JopKoning-InsyteTechnology/EFRO_Breast_Cancer_Detection/impedance-match-USB.png

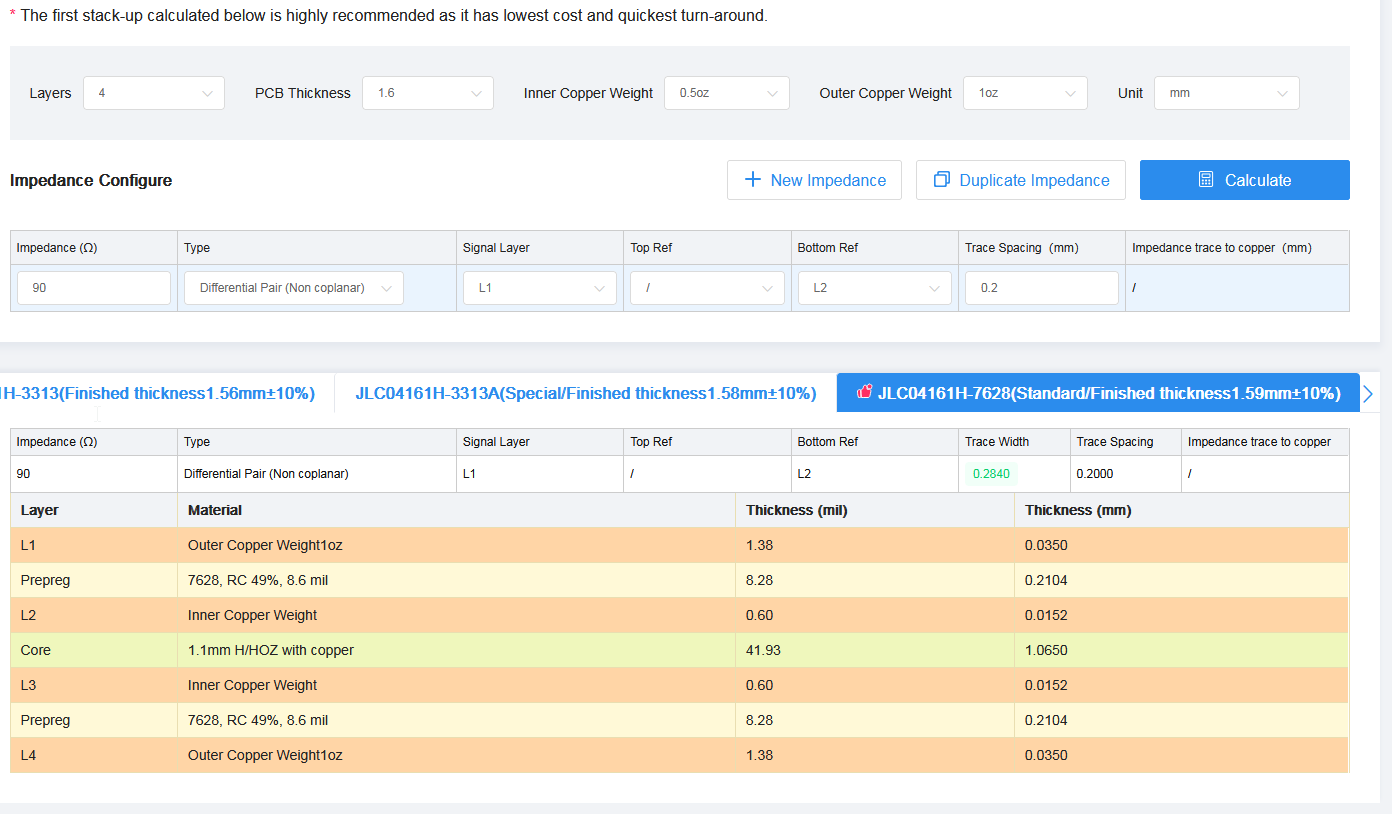
impedance-match-USB.png
