JopKoning-InsyteTechnology/EFRO_Breast_Cancer_Detection/Minimal_Prototype_Function_Generator_V0.1/Minimal_Prototype_Function_Generator_V0.1.kicad_pcb

## KiCad design Minimal_Prototype_Function_Generator_V0.1/Minimal_Prototype_Function_Generator_V0.1.kicad_pcb (2025-09-29)

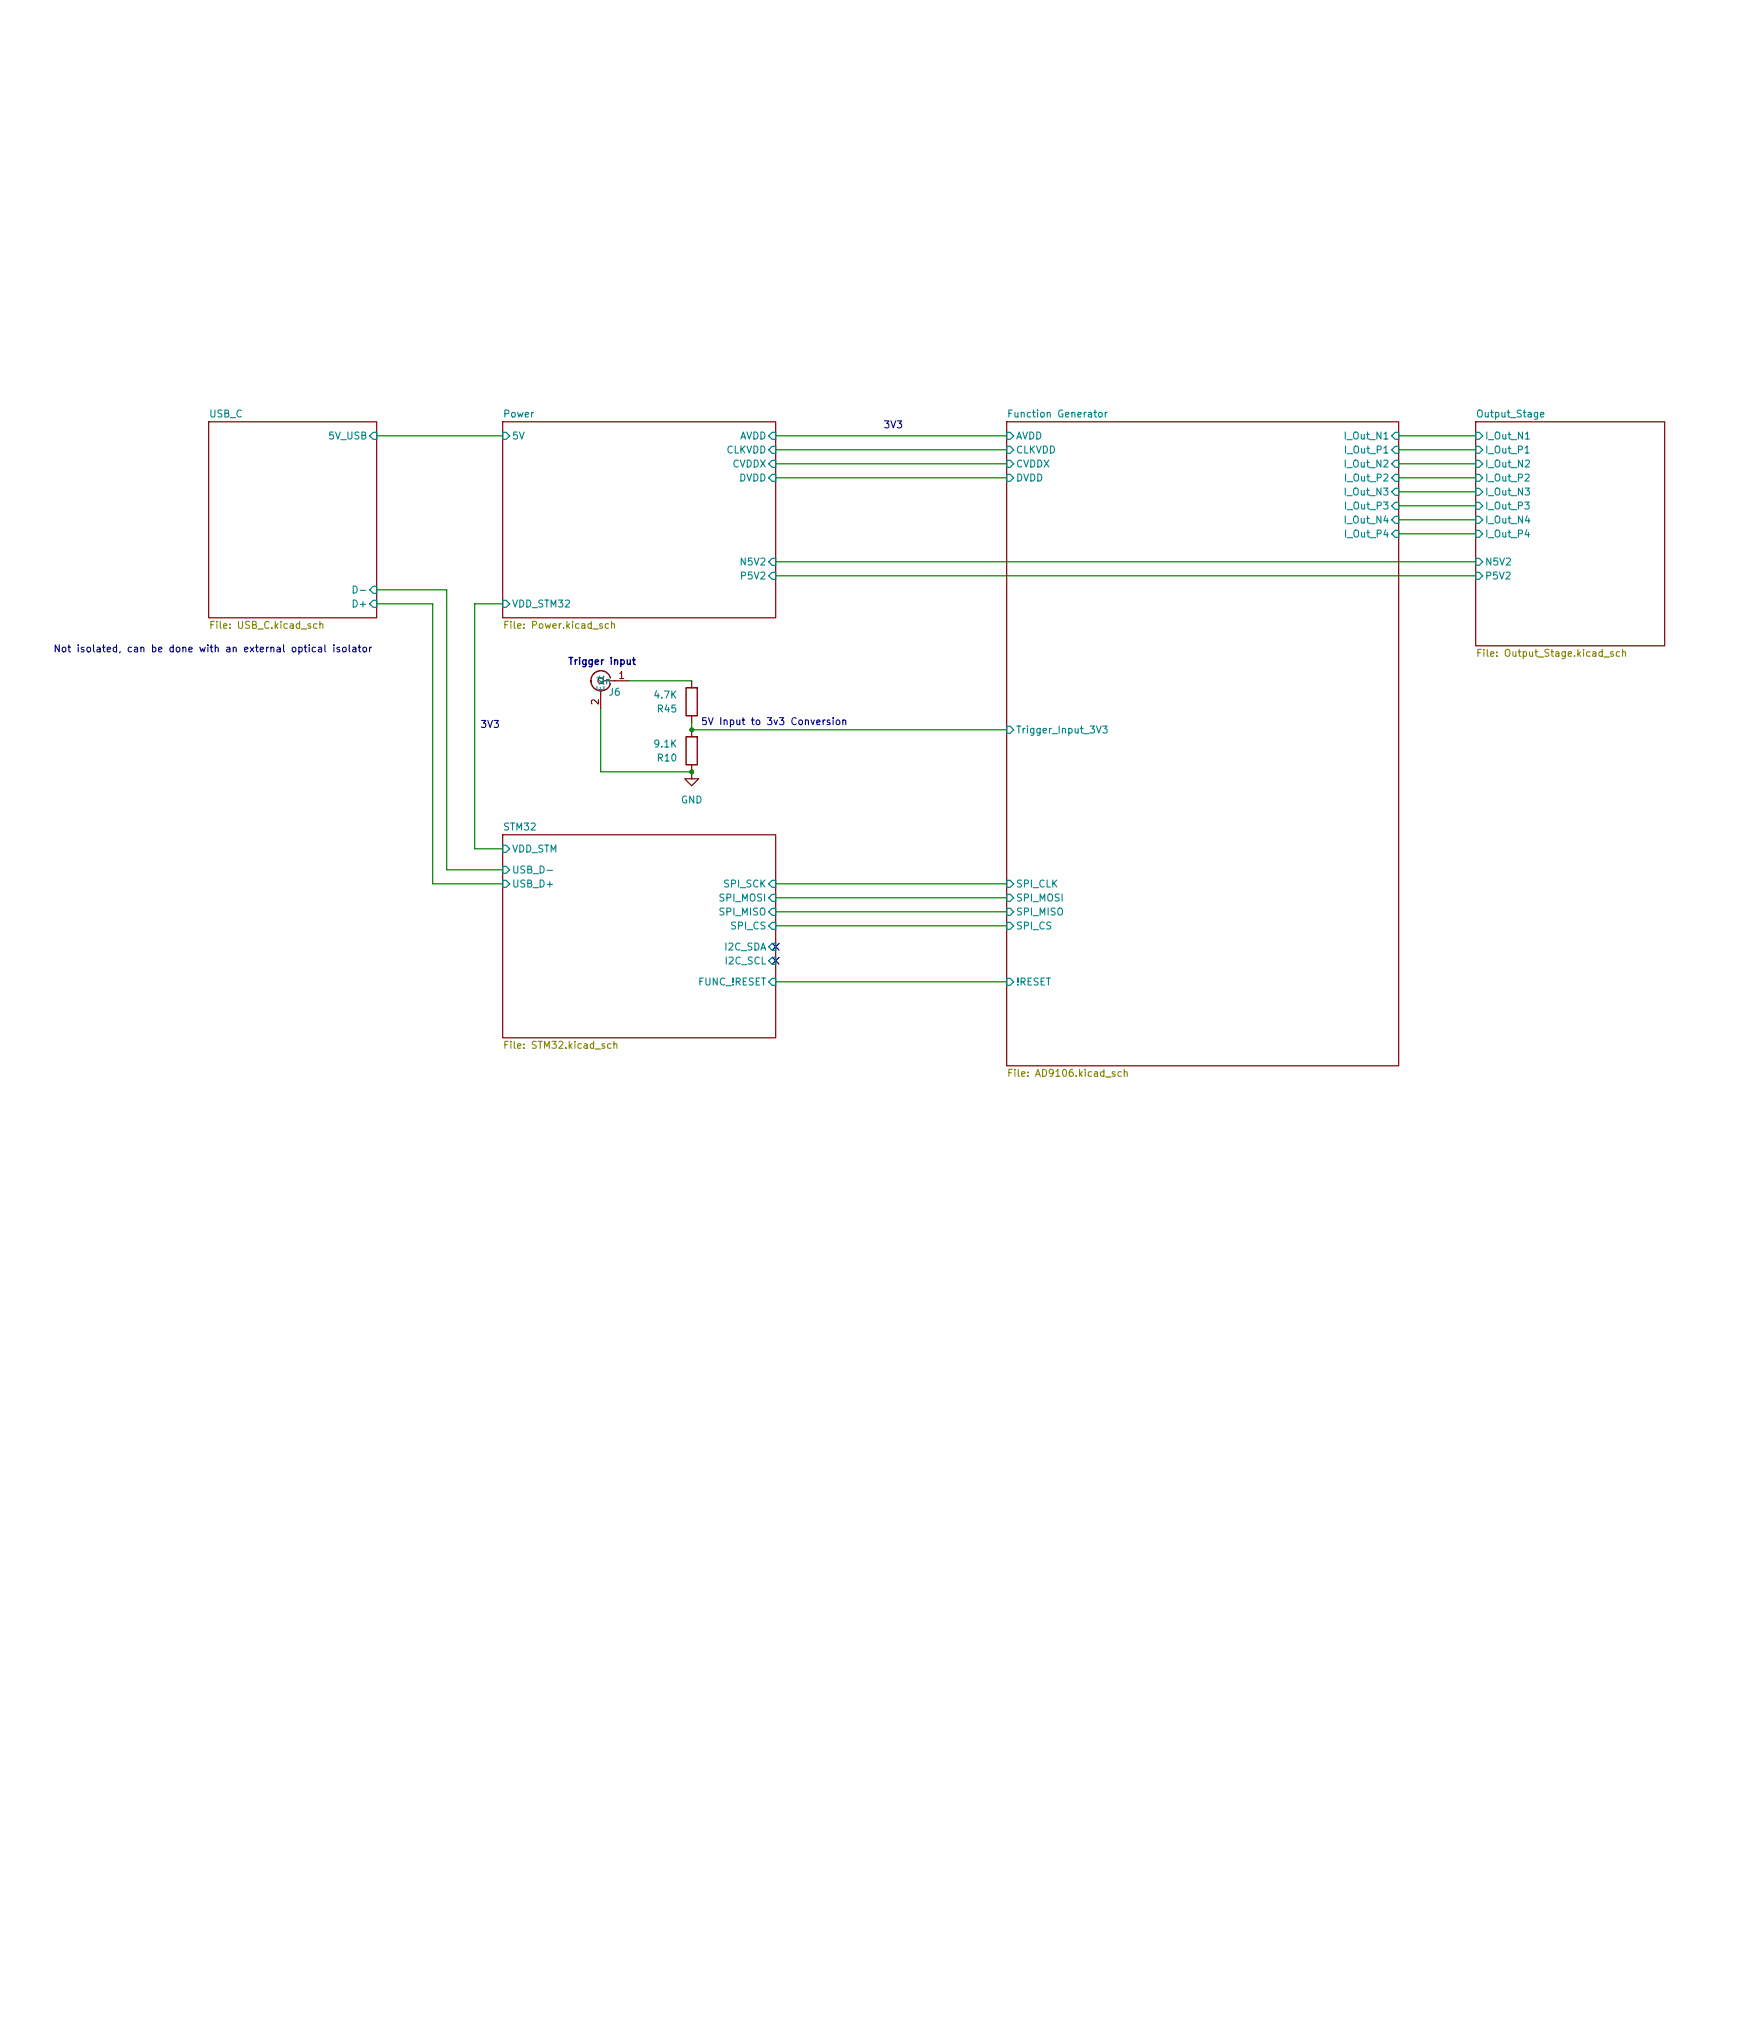
[picture p2: schematic Minimal_Prototype_Function_Generator_V0.1.kicad_sch, part in row 1, column 1]

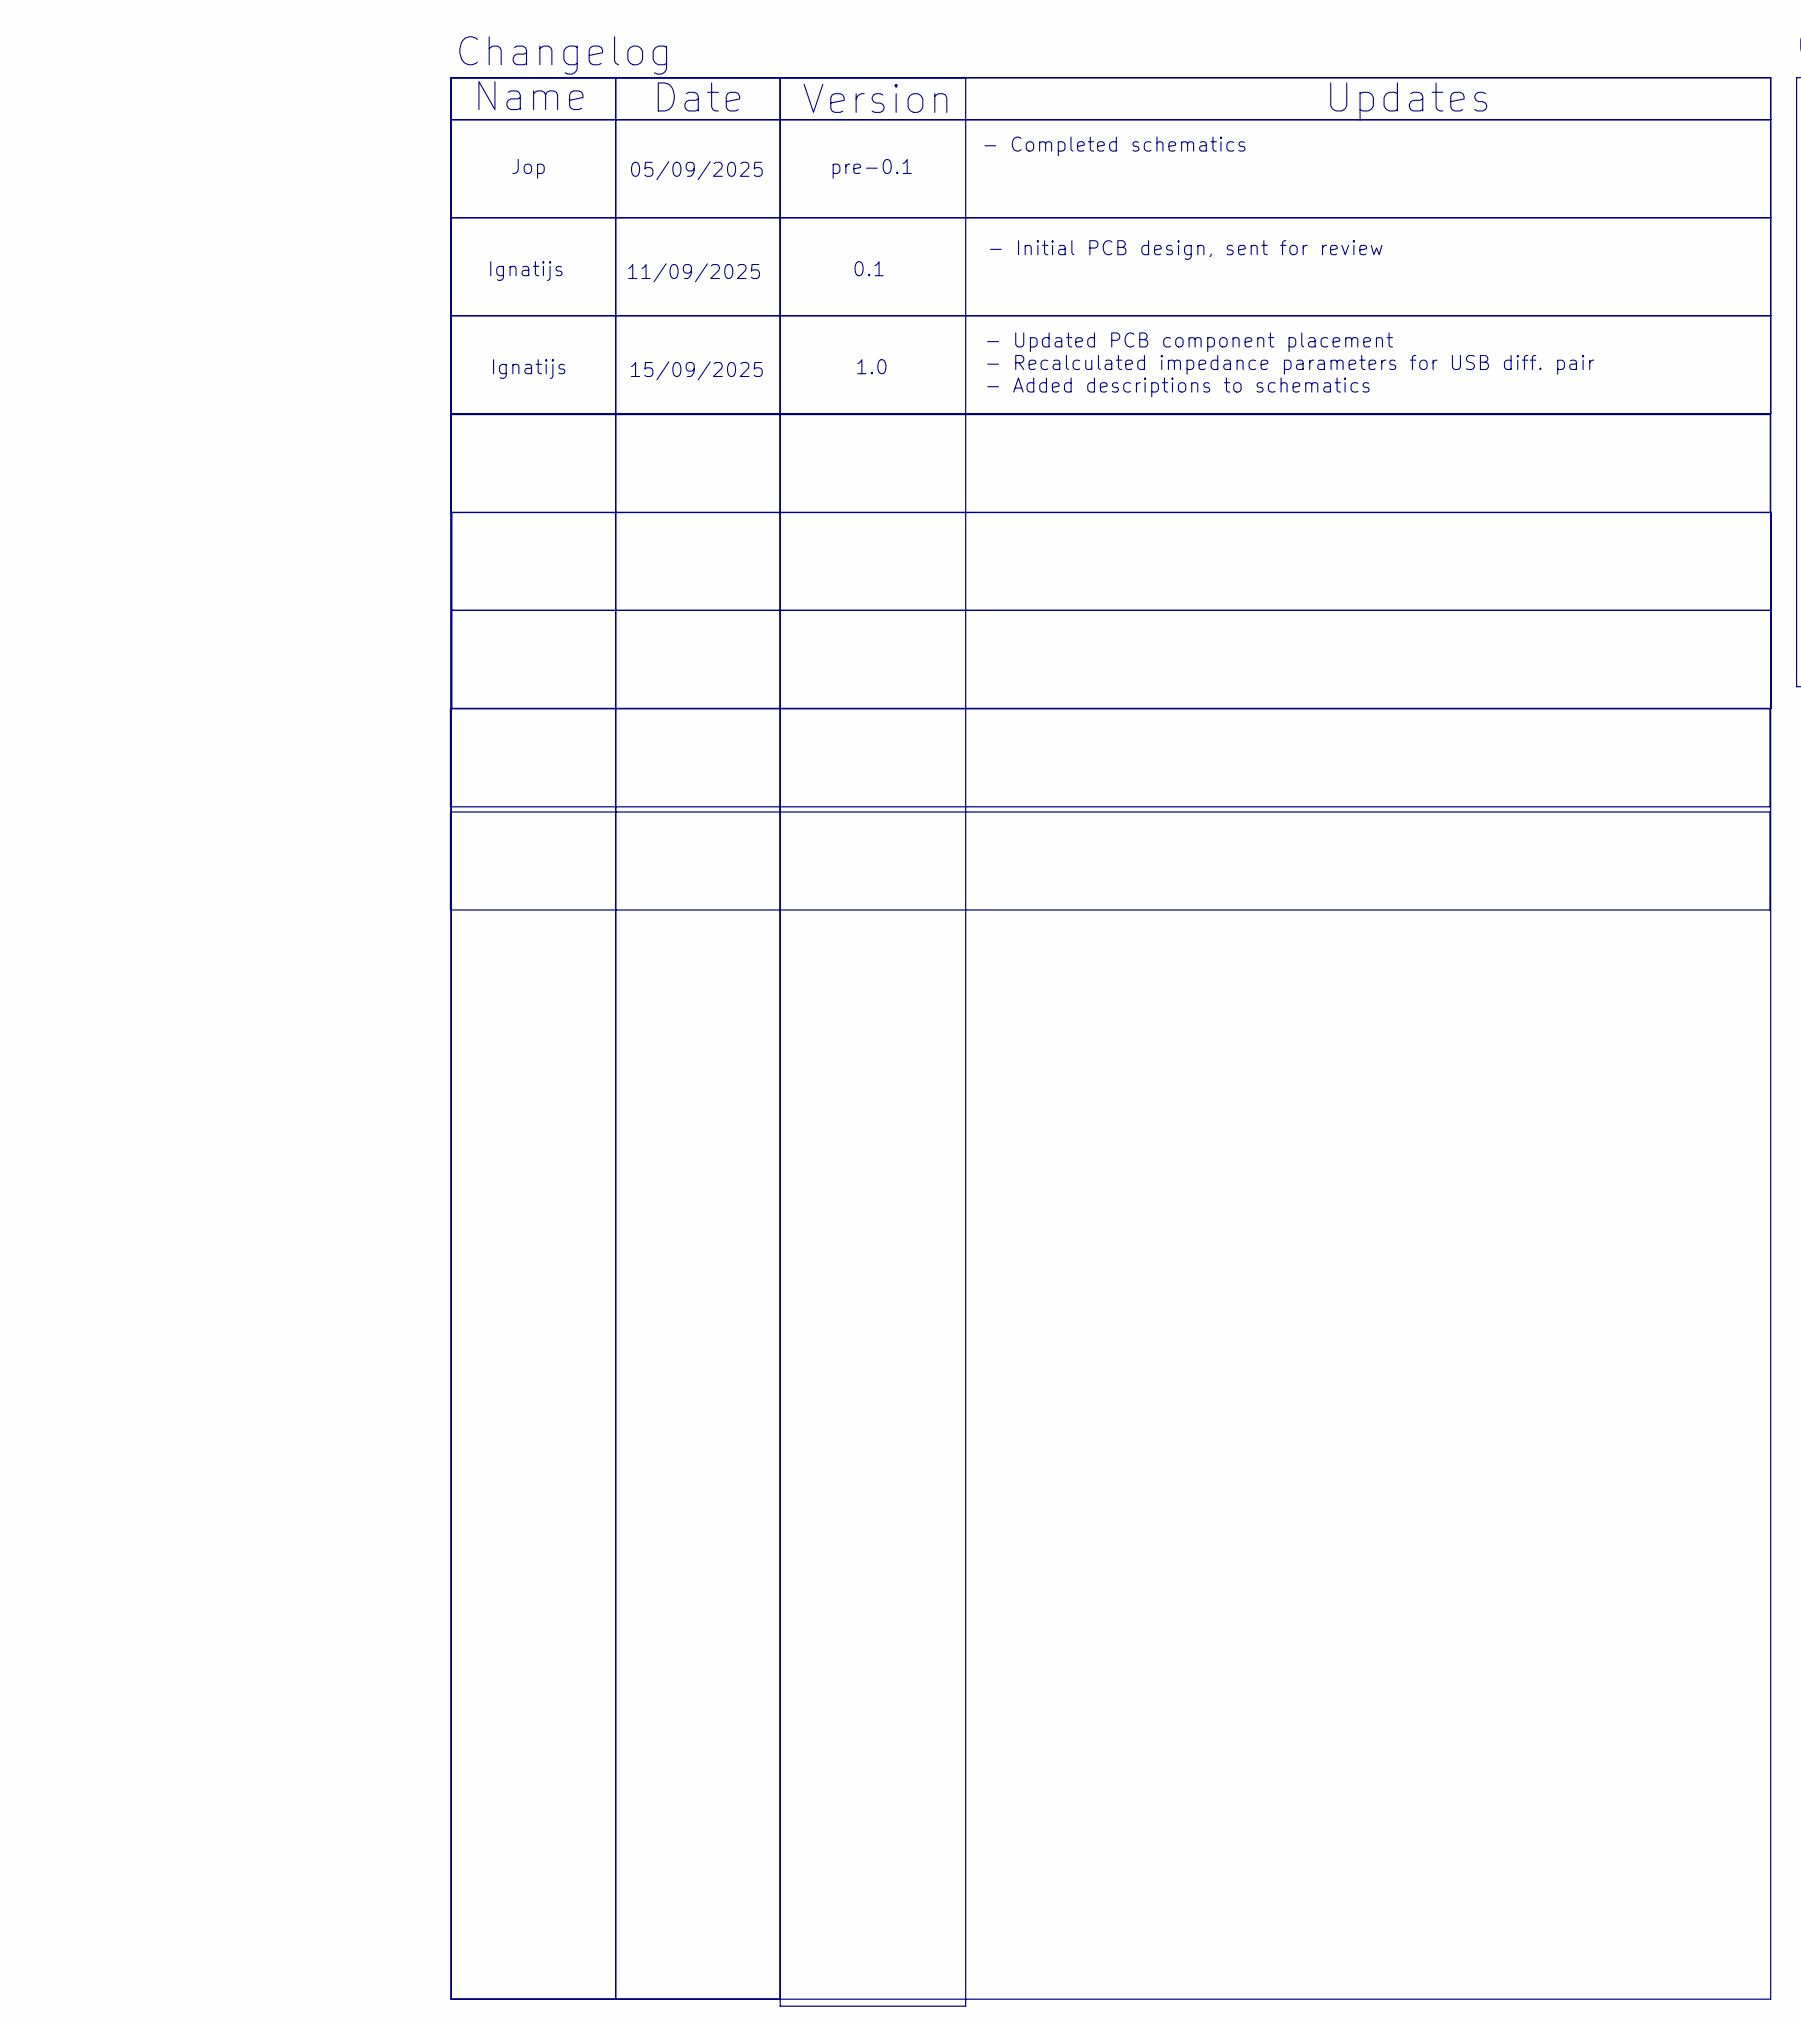
[picture p3: schematic Minimal_Prototype_Function_Generator_V0.1.kicad_sch, part in row 1, column 2]

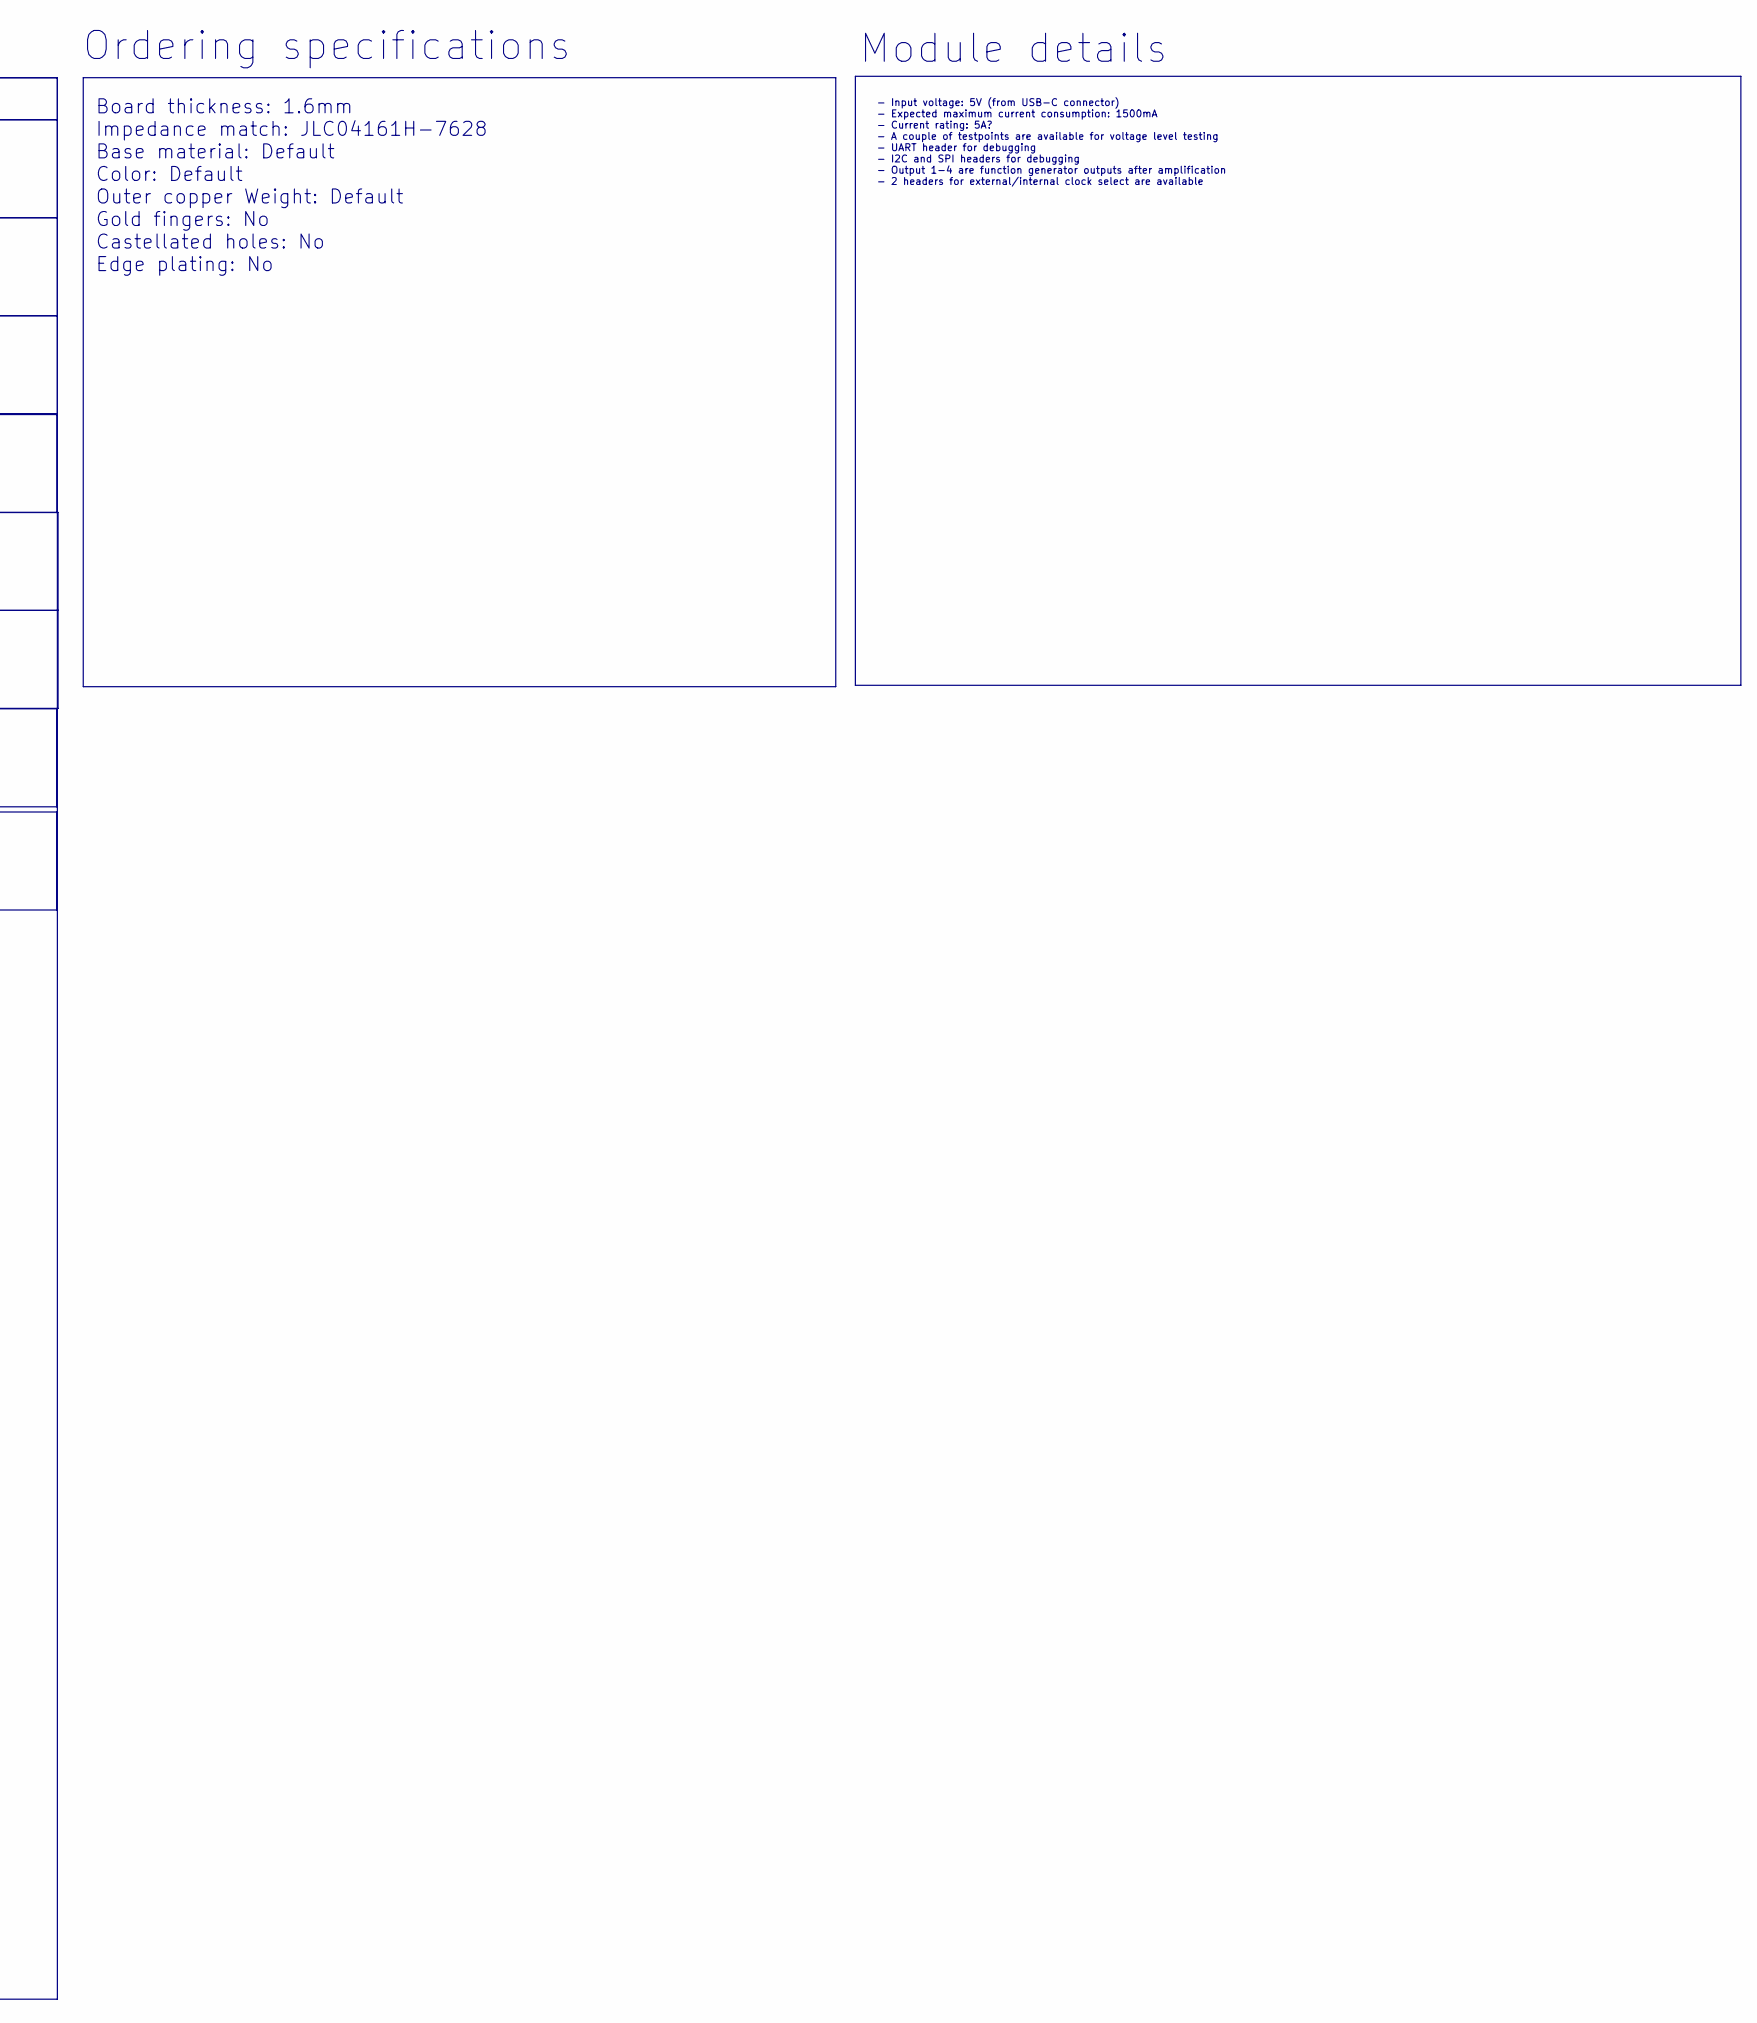
[picture p4: schematic Minimal_Prototype_Function_Generator_V0.1.kicad_sch, part in row 1, column 3]

Parts:
J6: 142-0701-201; 1420701201; Mouser Part Number 530-142-0701-201
R10: 9.1K; R_0603_1608Metric
R45: 4.7K; R_0603_1608Metric

Connections:
/Function Generator/Trigger_Input_3V3: R10.2, R45.1; also elsewhere on the board
GND: J6.2 (Ext), J6.3 (Ext), J6.4 (Ext), J6.5 (Ext), R10.1; also elsewhere on the board
unnamed: J6.1 (In), R45.2

Notes on the sheet:
1.0
- Updated PCB component placement - Recalculated impedance parameters for USB diff. pair - Added descriptions to schematics
- Input voltage: 5V (from USB-C connector) - Expected maximum current consumption: 1500mA - Current rating: 5A? - A couple of testpoints are available for voltage level testing - UART header for debugging - I2C and SPI headers for debugging - Output 1-4 are function generator outputs after amplific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
05/09/2025
pre-0.1
3V3
11/09/2025
Updates
Ignatijs
- Completed schematics
- Initial PCB design, sent for review
Ordering specifications
Module details
Trigger input
Changelog
Version
5V Input to 3v3 Conversion
0.1
15/09/2025
Date
Jop
Name
Not isolated, can be done with an external optical isolator
Board thickness: 1.6mm Impedance match: JLC04161H-7628 Base material: Default Color: Default Outer copper Weight: Default Gold fingers: No Castellated holes: No Edge plating: No

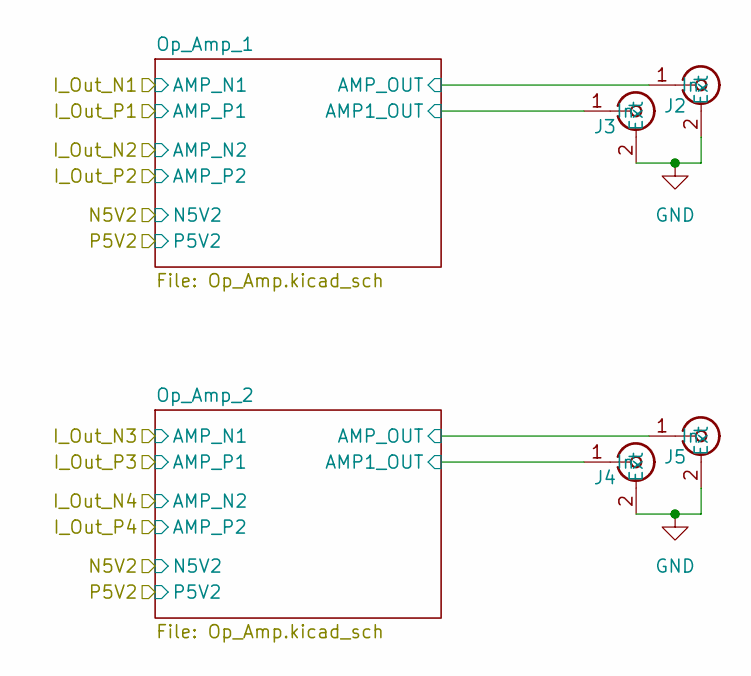
[picture p5: schematic Output_Stage.kicad_sch]

Parts:
J2, J3, J4, J5: 142-0701-201; 1420701201; Mouser Part Number 530-142-0701-201

Connections:
/Output_Stage/Op_Amp_1/AMP1_OUT: J3.1 (In); also elsewhere on the board
/Output_Stage/Op_Amp_1/AMP_OUT: J2.1 (In); also elsewhere on the board
/Output_Stage/Op_Amp_2/AMP1_OUT: J4.1 (In); also elsewhere on the board
/Output_Stage/Op_Amp_2/AMP_OUT: J5.1 (In); also elsewhere on the board
GND: J2.2 (Ext), J2.3 (Ext), J2.4 (Ext), J2.5 (Ext), J3.2 (Ext), J3.3 (Ext), J3.4 (Ext), J3.5 (Ext), J4.2 (Ext), J4.3 (Ext), J4.4 (Ext), J4.5 (Ext), J5.2 (Ext), J5.3 (Ext), J5.4 (Ext), J5.5 (Ext); also elsewhere on the board

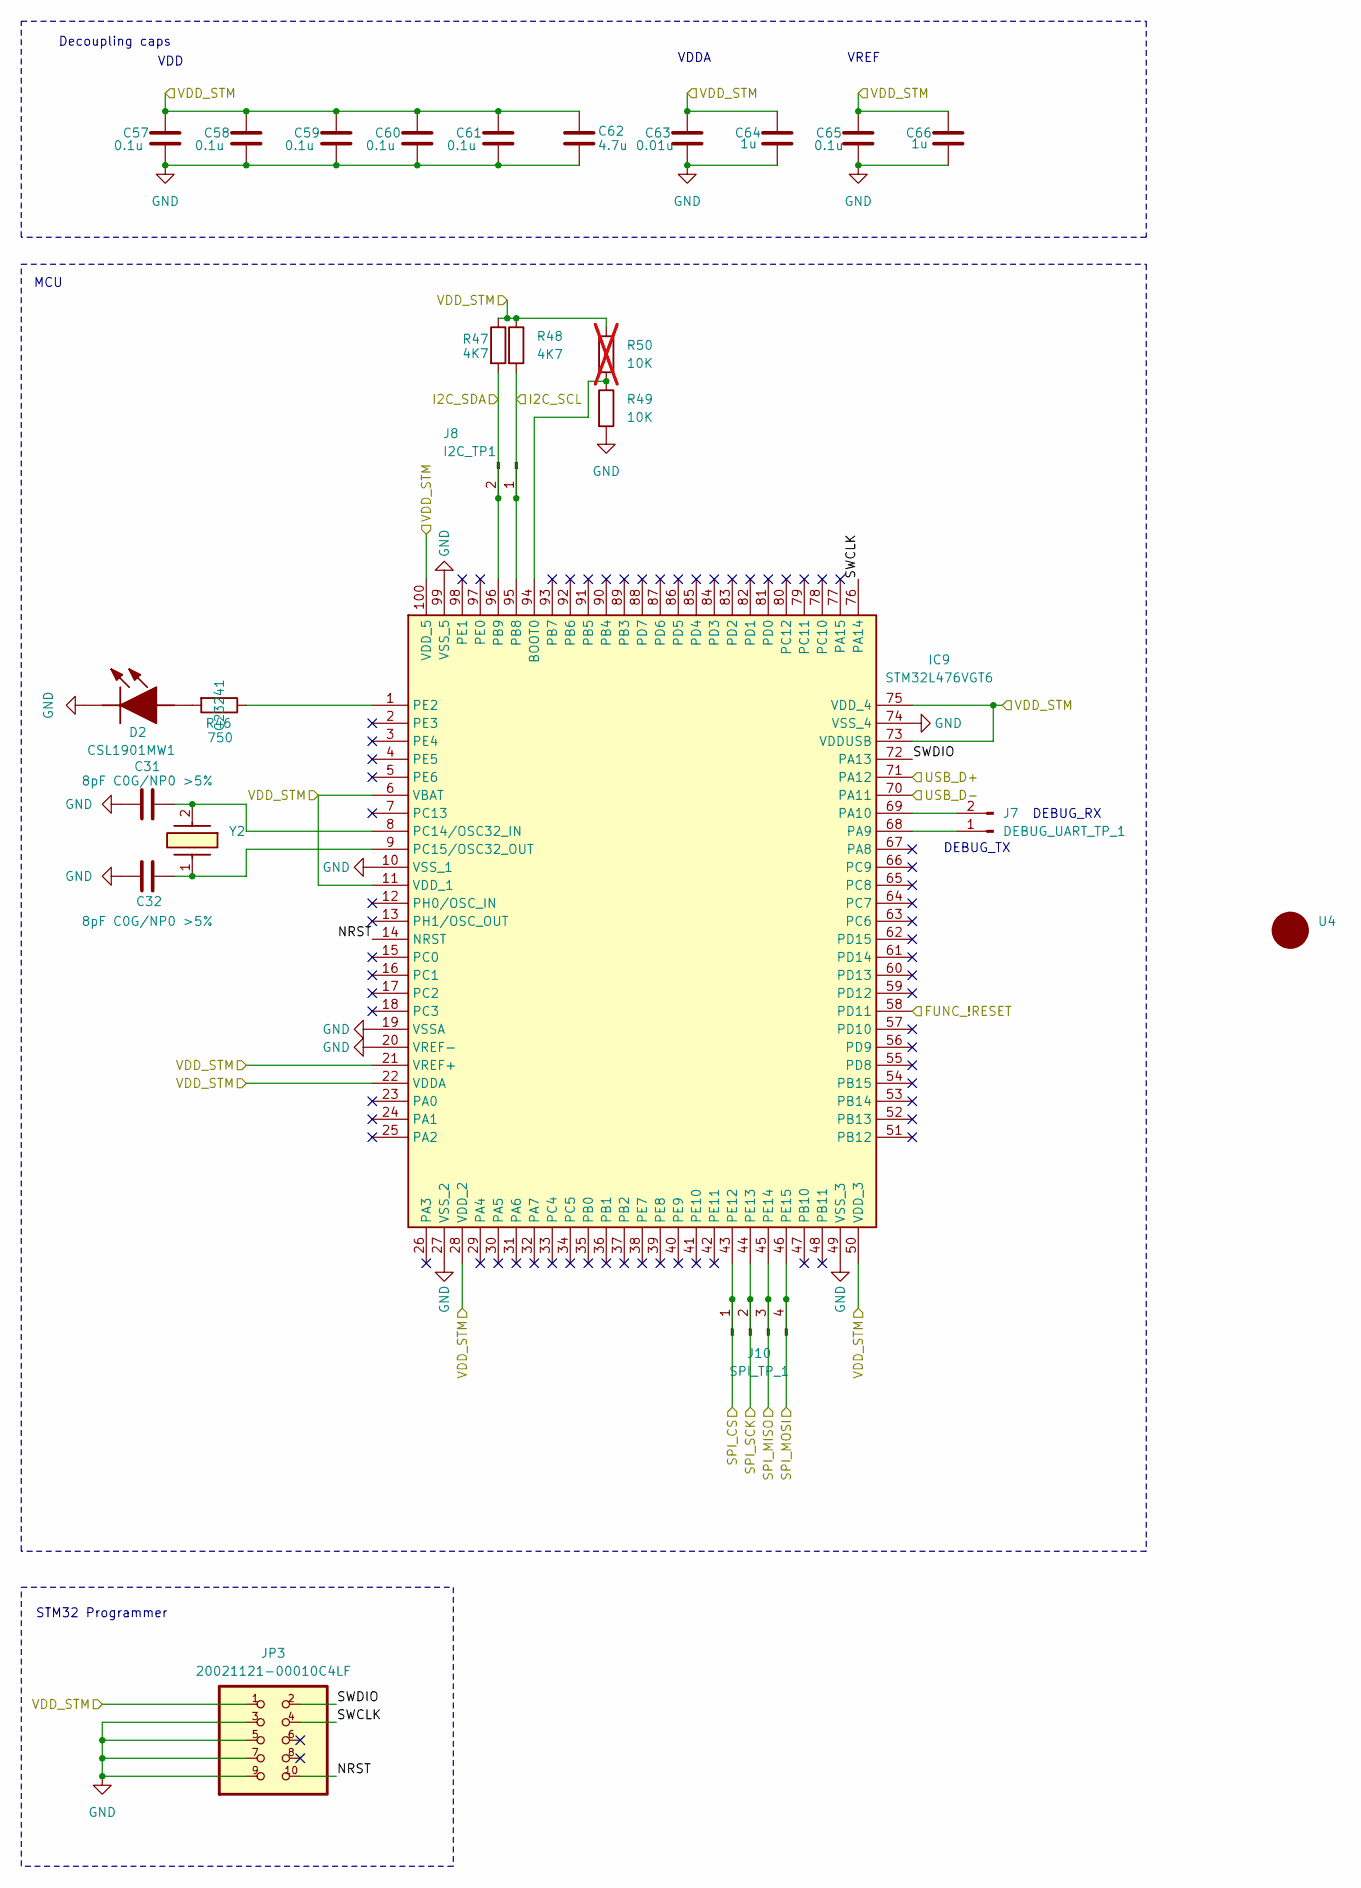
[picture p6: schematic STM32.kicad_sch]

Parts:
C31, C32: 8pF C0G/NP0 >5%; C_0603_1608Metric; LCSC Part # C36508
C57, C58, C59, C60, C61, C65: 0.1u; C_0603_1608Metric; voltage rating 16V; LCSC Part # C14663
C62: 4.7u; C_0603_1608Metric; voltage rating 16V; LCSC Part # C19702
C63: 0.01u; C_0603_1608Metric; voltage rating 16V; LCSC Part # C1589
C64, C66: 1u; C_0603_1608Metric; voltage rating 16V; LCSC Part # C15849
D2: CSL1901MW1; Mouser Part Number 755-CSL1901MW1
IC9: STM32L476VGT6; QFP50P1600X1600X160-100N; Mouser Part Number 511-STM32L476VGT6
J7: DEBUG_UART_TP_1; PinHeader_1x02_P2.54mm_Vertical
J8: I2C_TP1; PinHeader_1x02_P2.54mm_Vertical
J10: SPI_TP_1; PinHeader_1x04_P2.54mm_Vertical
JP3: 20021121-00010C4LF; 2002112100010C4LF; LCSC Part # C150517
R46: 750; R_0603_1608Metric; LCSC Part # C23241
R47, R48: 4K7; R_0603_1608Metric; LCSC Part # C23162
R49: 10K; R_0603_1608Metric; LCSC Part # C23162
R50: 10K; R_0603_1608Metric; LCSC Part # C23162; not fitted
U4: 15x6_Insyte_Logo
Y2: ECS-.327-7-16-C-TR; ECS327516TR; Mouser Part Number 520-.327-7-16-CT

Connections:
/Function Generator/!RESET: IC9.58 (PD11); also elsewhere on the board
/Function Generator/SPI_CLK: IC9.44 (PE13), J10.2; also elsewhere on the board
/Function Generator/SPI_CS: IC9.43 (PE12), J10.1; also elsewhere on the board
/Function Generator/SPI_MISO: IC9.45 (PE14), J10.3; also elsewhere on the board
/Function Generator/SPI_MOSI: IC9.46 (PE15), J10.4; also elsewhere on the board
/Power/VDD_STM32: C57.1, C58.1, C59.1, C60.1, C61.1, C62.1, C63.1, C64.1, C65.1, C66.1, IC9.6 (VBAT), IC9.11 (VDD_1), IC9.21 (VREF+), IC9.22 (VDDA), IC9.28 (VDD_2), IC9.50 (VDD_3), IC9.73 (VDDUSB), IC9.75 (VDD_4), IC9.100 (VDD_5), JP3.1, R47.1, R48.1, R50.1; also elsewhere on the board
/STM32/I2C_SCL: IC9.95 (PB8), J8.1, R48.2
/STM32/I2C_SDA: IC9.96 (PB9), J8.2, R47.2
/STM32/NRST: IC9.14 (NRST), JP3.10
/STM32/SWCLK: IC9.76 (PA14), JP3.4
/STM32/SWDIO: IC9.72 (PA13), JP3.2
/USB_C/D+: IC9.71 (PA12); also elsewhere on the board
/USB_C/D-: IC9.70 (PA11); also elsewhere on the board
GND: C31.1, C32.1, C57.2, C58.2, C59.2, C60.2, C61.2, C62.2, C63.2, C64.2, C65.2, C66.2, D2.1 (K), IC9.10 (VSS_1), IC9.19 (VSSA), IC9.20 (VREF-), IC9.27 (VSS_2), IC9.49 (VSS_3), IC9.74 (VSS_4), IC9.99 (VSS_5), JP3.3, JP3.5, JP3.7, JP3.9, R49.2; also elsewhere on the board
unnamed: D2.2 (A), R46.2
unnamed: IC9.94 (BOOT0), R49.1, R50.2
unnamed: IC9.68 (PA9), J7.1
unnamed: IC9.69 (PA10), J7.2
unnamed: C31.2, IC9.8 (PC14/OSC32_IN), Y2.2 (OUT/IN)
unnamed: C32.2, IC9.9 (PC15/OSC32_OUT), Y2.1
unnamed: IC9.1 (PE2), R46.1

Notes on the sheet:
STM32 Programmer
VREF
MCU
VDD
VDDA
Decoupling caps
DEBUG_RX
DEBUG_TX

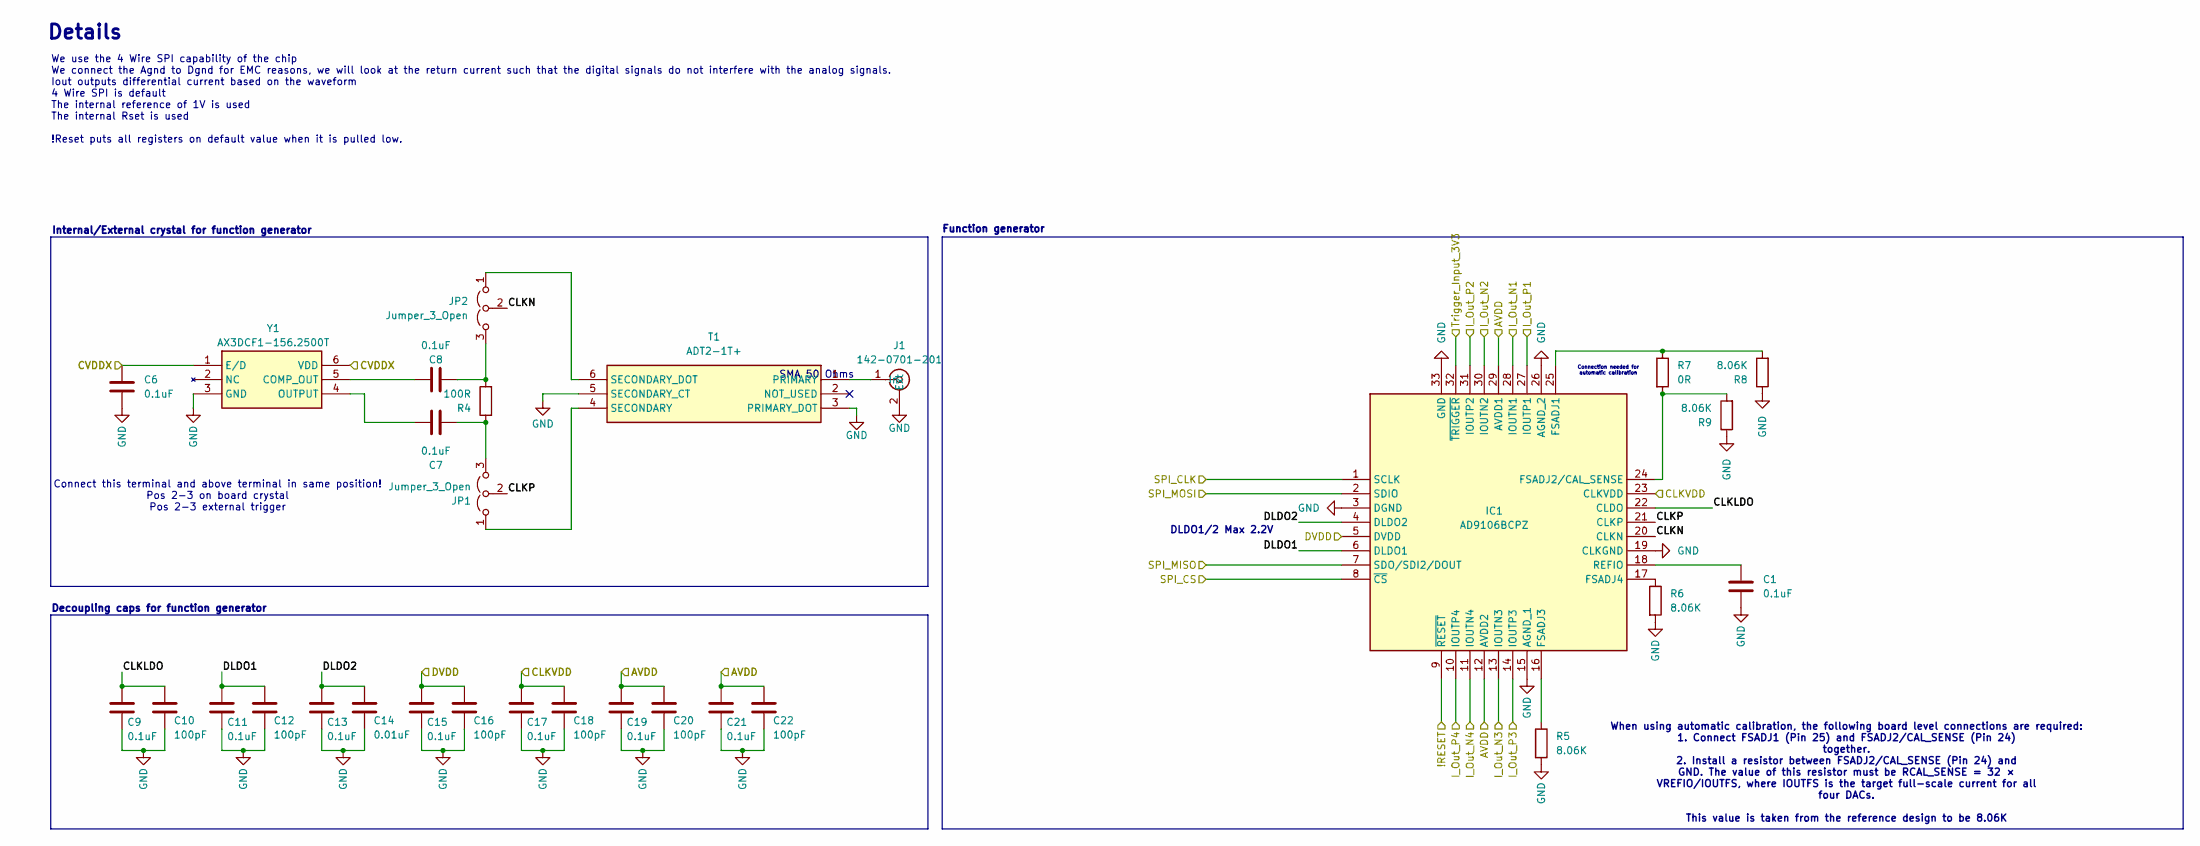
[picture p7: schematic AD9106.kicad_sch]

Parts:
C1, C6, C7, C8, C9, C11, C13, C15, C17, C19, C21: 0.1uF; C_0603_1608Metric
C10, C12, C16, C18, C20, C22: 100pF; C_0603_1608Metric
C14: 0.01uF; C_0603_1608Metric
IC1: AD9106BCPZ; QFN50P500X500X80-33N-D; Mouser Part Number 584-AD9106BCPZ
J1: 142-0701-201; 1420701201; Mouser Part Number 530-142-0701-201
JP1, JP2: Jumper_3_Open; PinHeader_1x03_P2.54mm_Vertical
R4: 100R; R_0603_1608Metric
R5, R6, R8, R9: 8.06K; R_0603_1608Metric
R7: 0R; R_0603_1608Metric
T1: ADT2-1T+; ADT21T; Mouser Part Number 139-ADT2-1T
Y1: AX3DCF1-156.2500T; AX3_3.2x2.5; Mouser Part Number 815-AX3DCF1156.2500T

Connections:
/Function Generator/!RESET: IC1.9 (~RESET); also elsewhere on the board
/Function Generator/AVDD: C19.1, C20.1, C21.1, C22.1, IC1.12 (AVDD2), IC1.29 (AVDD1); also elsewhere on the board
/Function Generator/CLKLDO: C9.1, C10.1, IC1.22 (CLDO)
/Function Generator/CLKN: IC1.20 (CLKN), JP2.2 (C)
/Function Generator/CLKP: IC1.21 (CLKP), JP1.2 (C)
/Function Generator/CLKVDD: C17.1, C18.1, IC1.23 (CLKVDD); also elsewhere on the board
/Function Generator/CVDDX: C6.1, Y1.1 (E/D), Y1.6 (VDD); also elsewhere on the board
/Function Generator/DLDO1: C11.1, C12.1, IC1.6 (DLDO1)
/Function Generator/DLDO2: C13.1, C14.1, IC1.4 (DLDO2)
/Function Generator/DVDD: C15.1, C16.1, IC1.5 (DVDD); also elsewhere on the board
/Function Generator/I_Out_N1: IC1.28 (IOUTN1); also elsewhere on the board
/Function Generator/I_Out_N2: IC1.30 (IOUTN2); also elsewhere on the board
/Function Generator/I_Out_N3: IC1.13 (IOUTN3); also elsewhere on the board
/Function Generator/I_Out_N4: IC1.11 (IOUTN4); also elsewhere on the board
/Function Generator/I_Out_P1: IC1.27 (IOUTP1); also elsewhere on the board
/Function Generator/I_Out_P2: IC1.31 (IOUTP2); also elsewhere on the board
/Function Generator/I_Out_P3: IC1.14 (IOUTP3); also elsewhere on the board
/Function Generator/I_Out_P4: IC1.10 (IOUTP4); also elsewhere on the board
/Function Generator/SPI_CLK: IC1.1 (SCLK); also elsewhere on the board
/Function Generator/SPI_CS: IC1.8 (~CS); also elsewhere on the board
/Function Generator/SPI_MISO: IC1.7 (SDO/SDI2/DOUT); also elsewhere on the board
/Function Generator/SPI_MOSI: IC1.2 (SDIO); also elsewhere on the board
/Function Generator/Trigger_Input_3V3: IC1.32 (~TRIGGER); also elsewhere on the board
GND: C1.2, C6.2, C9.2, C10.2, C11.2, C12.2, C13.2, C14.2, C15.2, C16.2, C17.2, C18.2, C19.2, C20.2, C21.2, C22.2, IC1.3 (DGND), IC1.15 (AGND_1), IC1.19 (CLKGND), IC1.26 (AGND_2), IC1.33 (GND), J1.2 (Ext), J1.3 (Ext), J1.4 (Ext), J1.5 (Ext), R5.2, R6.2, R8.1, R9.1, T1.3 (PRIMARY_DOT), T1.5 (SECONDARY_CT), Y1.3 (GND); also elsewhere on the board
unnamed: IC1.25 (FSADJ1), R7.1, R8.2
unnamed: IC1.24 (FSADJ2/CAL_SENSE), R7.2, R9.2
unnamed: IC1.16 (FSADJ3), R5.1
unnamed: IC1.17 (FSADJ4), R6.1
unnamed: C1.1, IC1.18 (REFIO)
unnamed: J1.1 (In), T1.1 (PRIMARY)
unnamed: JP1.1 (A), T1.4 (SECONDARY)
unnamed: C7.2, JP1.3 (B), R4.1
unnamed: JP2.1 (A), T1.6 (SECONDARY_DOT)
unnamed: C8.2, JP2.3 (B), R4.2
unnamed: C8.1, Y1.5 (COMP_OUT)
unnamed: C7.1, Y1.4 (OUTPUT)

Notes on the sheet:
DLDO1/2 Max 2.2V
Connect this terminal and above terminal in same position! Pos 2-3 on board crystal Pos 2-3 external trigger
Function generator
Details
Connection needed for automatic calibration
SMA 50 Ohms
Internal/External crystal for function generator
We use the 4 Wire SPI capability of the chip We connect the Agnd to Dgnd for EMC reasons, we will look at the return current such that the digital signals do not interfere with the analog signals. Iout outputs differential current based on the waveform 4 Wire SPI is default The internal reference o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
When using automatic calibration, the following board level connections are required: 1. Connect FSADJ1 (Pin 25) and FSADJ2/CAL_SENSE (Pin 24) together. 2. Install a resistor between FSADJ2/CAL_SENSE (Pin 24) and GND. The value of this resistor must be RCAL_SENSE = 32 × VREFIO/IOUTFS, where IOUTFS 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
Decoupling caps for function generator

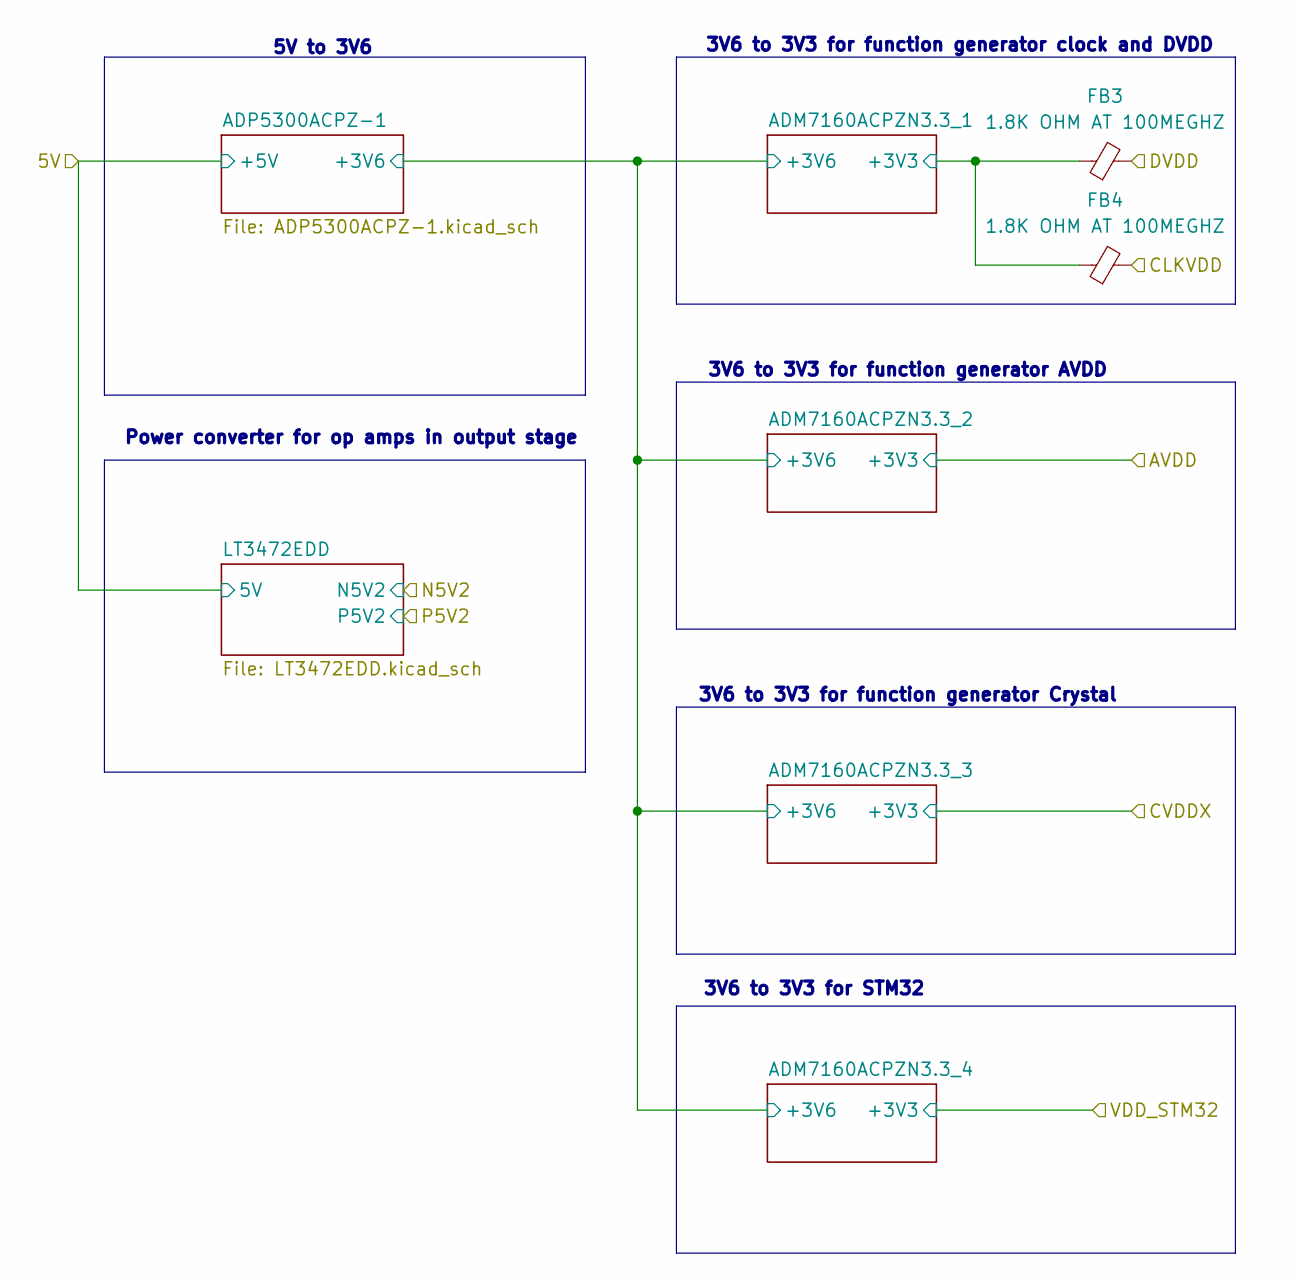
[picture p8: schematic Power.kicad_sch]

Parts:
FB3, FB4: 1.8K OHM AT 100MEGHZ; L_0603_1608Metric

Connections:
/Function Generator/CLKVDD: FB4.2; also elsewhere on the board
/Function Generator/DVDD: FB3.2; also elsewhere on the board
/Power/ADM7160ACPZN3.3_1/+3V3: FB3.1, FB4.1; also elsewhere on the board

Notes on the sheet:
3V6 to 3V3 for function generator clock and DVDD
3V6 to 3V3 for function generator AVDD
3V6 to 3V3 for STM32
3V6 to 3V3 for function generator Crystal
Power converter for op amps in output stage
5V to 3V6
