JopKoning-InsyteTechnology/EFRO_Breast_Cancer_Detection/Minimal_Prototype_Function_Generator_V0.1/Minimal_Prototype_Function_Generator_V0.1.kicad_pcb

## KiCad design Minimal_Prototype_Function_Generator_V0.1/Minimal_Prototype_Function_Generator_V0.1.kicad_pcb (continued)

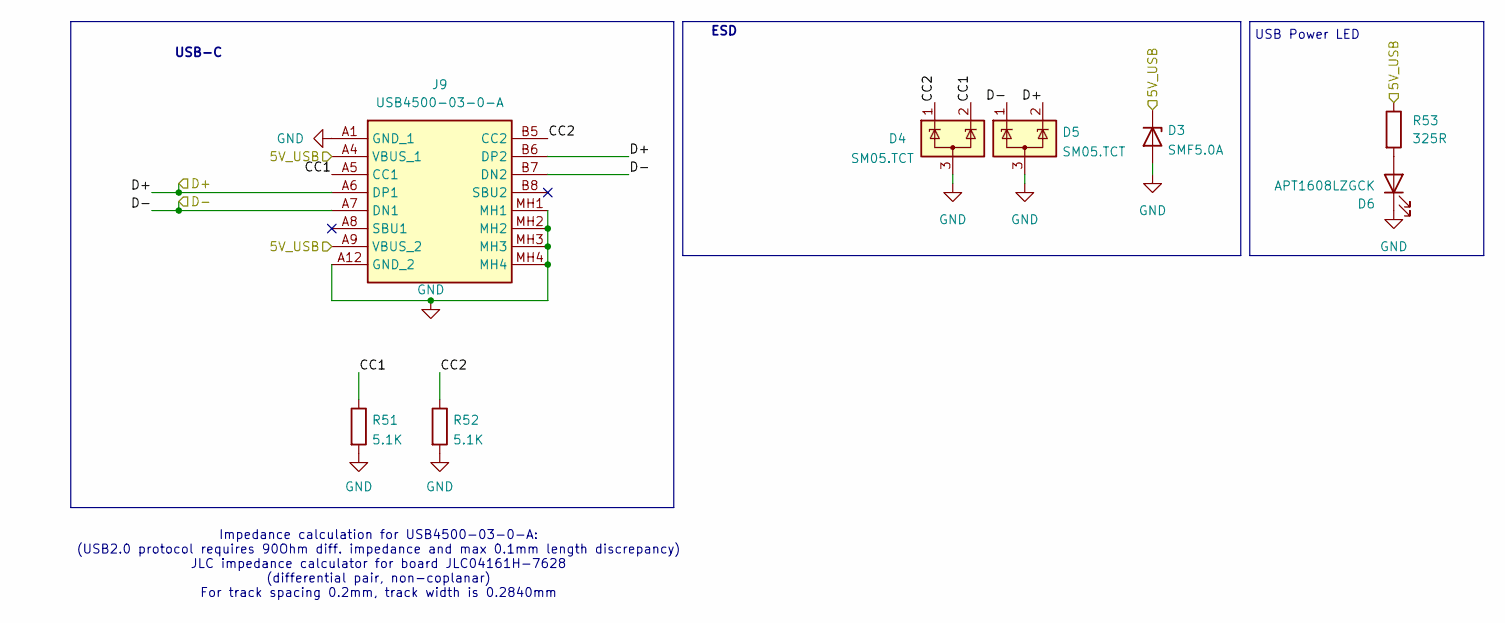
[picture p9: schematic USB_C.kicad_sch]

Parts:
D3: SMF5.0A; SODFL3618X110N; Manufacturer_Part_Number SMF5.0A; LCSC Part # C193402
D4, D5: SM05.TCT; SOT95P237X125-3N; Manufacturer_Part_Number SM05.TCT; LCSC Part # C2687125
D6: APT1608LZGCK; LEDC1608X85N; Manufacturer_Part_Number APT1608LZGCK
J9: USB4500-03-0-A; USB4500030A; Mouser Part Number 640-USB4500030A
R51, R52: 5.1K; R_0603_1608Metric; Manufacturer_Part_Number RT0603FRD075K1L; LCSC Part # C23186
R53: 325R; R_0603_1608Metric; Manufacturer_Part_Number RC0603FR-1325K5L

Connections:
/Power/5V: D3.1 (K), J9.A4 (VBUS_1), J9.A9 (VBUS_2), R53.1; also elsewhere on the board
/USB_C/CC1: D4.2 (K), J9.A5 (CC1), R51.1
/USB_C/CC2: D4.1 (K), J9.B5 (CC2), R52.1
/USB_C/D+: D5.2 (K), J9.A6 (DP1), J9.B6 (DP2); also elsewhere on the board
/USB_C/D-: D5.1 (K), J9.A7 (DN1), J9.B7 (DN2); also elsewhere on the board
GND: D3.2 (A), D4.3 (A), D5.3 (A), D6.1 (K), J9.A1 (GND_1), J9.A12 (GND_2), J9.MH1, J9.MH2, J9.MH3, J9.MH4, R51.2, R52.2; also elsewhere on the board
unnamed: D6.2 (A), R53.2

Notes on the sheet:
Impedance calculation for USB4500-03-0-A: (USB2.0 protocol requires 90Ohm diff. impedance and max 0.1mm length discrepancy) JLC impedance calculator for board JLC04161H-7628 (differential pair, non-coplanar) For track spacing 0.2mm, track width is 0.2840mm
ESD
USB-C
USB Power LED

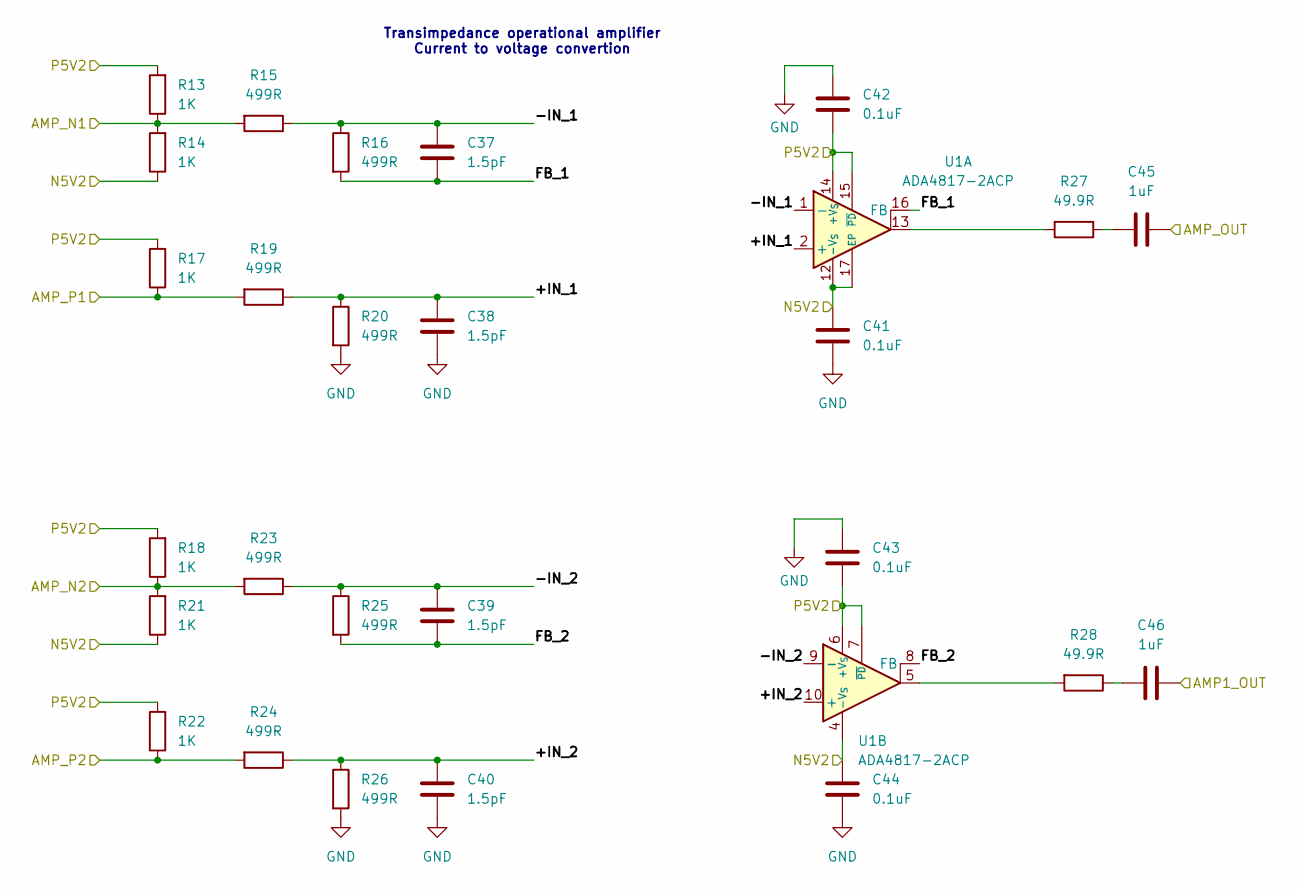
[picture p10: schematic Op_Amp.kicad_sch]

Parts:
C37, C38, C39, C40: 1.5pF; C_0603_1608Metric
C41, C42, C43, C44: 0.1uF; C_0603_1608Metric
C45, C46: 1uF; C_0603_1608Metric
R13, R14, R17, R18, R21, R22: 1K; R_0603_1608Metric
R15, R16, R19, R20, R23, R24, R25, R26: 499R; R_0603_1608Metric
R27, R28: 49.9R; R_0603_1608Metric
U1: ADA4817-2ACP; Analog_LFCSP-16-1EP_4x4mm_P0.65mm_EP2.35x2.35mm

Connections:
/Function Generator/I_Out_N1: R13.1, R14.2, R15.2; also elsewhere on the board
/Function Generator/I_Out_N2: R18.1, R21.2, R23.2; also elsewhere on the board
/Function Generator/I_Out_P1: R17.1, R19.2; also elsewhere on the board
/Function Generator/I_Out_P2: R22.1, R24.2; also elsewhere on the board
/Output_Stage/N5V2: C41.1, C44.1, R14.1, R21.1, U1.4 (-V_{S}), U1.12 (-V_{S}), U1.17 (EP); also elsewhere on the board
/Output_Stage/Op_Amp_1/+IN_1: C38.1, R19.1, R20.1, U1.2 (+)
/Output_Stage/Op_Amp_1/+IN_2: C40.1, R24.1, R26.1, U1.10 (+)
/Output_Stage/Op_Amp_1/-IN_1: C37.1, R15.1, R16.1, U1.1 (-)
/Output_Stage/Op_Amp_1/-IN_2: C39.1, R23.1, R25.1, U1.9 (-)
/Output_Stage/Op_Amp_1/AMP1_OUT: C46.2; also elsewhere on the board
/Output_Stage/Op_Amp_1/AMP_OUT: C45.2; also elsewhere on the board
/Output_Stage/Op_Amp_1/FB_1: C37.2, R16.2, U1.16 (FB)
/Output_Stage/Op_Amp_1/FB_2: C39.2, R25.2, U1.8 (FB)
/Output_Stage/P5V2: C42.2, C43.2, R13.2, R17.2, R18.2, R22.2, U1.6 (+V_{S}), U1.7 (~PD), U1.14 (+V_{S}), U1.15 (~PD); also elsewhere on the board
GND: C38.2, C40.2, C41.2, C42.1, C43.1, C44.2, R20.2, R26.2; also elsewhere on the board
unnamed: C45.1, R27.1
unnamed: C46.1, R28.1
unnamed: R27.2, U1.13
unnamed: R28.2, U1.5

Parts of its further copies:
C47, C48, C49, C50: 1.5pF; C_0603_1608Metric
C51, C52, C53, C54: 0.1uF; C_0603_1608Metric
C55, C56: 1uF; C_0603_1608Metric
R29, R30, R31, R32, R33, R34: 1K; R_0603_1608Metric
R35, R36, R37, R38, R39, R40, R41, R42: 499R; R_0603_1608Metric
R43, R44: 49.9R; R_0603_1608Metric
U3: ADA4817-2ACP; Analog_LFCSP-16-1EP_4x4mm_P0.65mm_EP2.35x2.35mm

Connections of its further copies:
/Function Generator/I_Out_N3: R29.1, R30.2, R35.2; also elsewhere on the board
/Function Generator/I_Out_N4: R32.1, R33.2, R37.2; also elsewhere on the board
/Function Generator/I_Out_P3: R31.1, R36.2; also elsewhere on the board
/Function Generator/I_Out_P4: R34.1, R38.2; also elsewhere on the board
/Output_Stage/N5V2: C52.1, C54.1, R30.1, R33.1, U3.4 (-V_{S}), U3.12 (-V_{S}), U3.17 (EP); also elsewhere on the board
/Output_Stage/Op_Amp_2/+IN_1: C48.1, R36.1, R40.1, U3.2 (+)
/Output_Stage/Op_Amp_2/+IN_2: C50.1, R38.1, R42.1, U3.10 (+)
/Output_Stage/Op_Amp_2/-IN_1: C47.1, R35.1, R39.1, U3.1 (-)
/Output_Stage/Op_Amp_2/-IN_2: C49.1, R37.1, R41.1, U3.9 (-)
/Output_Stage/Op_Amp_2/AMP1_OUT: C56.2; also elsewhere on the board
/Output_Stage/Op_Amp_2/AMP_OUT: C55.2; also elsewhere on the board
/Output_Stage/Op_Amp_2/FB_1: C47.2, R39.2, U3.16 (FB)
/Output_Stage/Op_Amp_2/FB_2: C49.2, R41.2, U3.8 (FB)
/Output_Stage/P5V2: C51.2, C53.2, R29.2, R31.2, R32.2, R34.2, U3.6 (+V_{S}), U3.7 (~PD), U3.14 (+V_{S}), U3.15 (~PD); also elsewhere on the board
GND: C48.2, C50.2, C51.1, C52.2, C53.1, C54.2, R40.2, R42.2; also elsewhere on the board
unnamed: C55.1, R43.1
unnamed: C56.1, R44.1
unnamed: R43.2, U3.13
unnamed: R44.2, U3.5

Notes on the sheet:
Transimpedance operational amplifier Current to voltage convertion

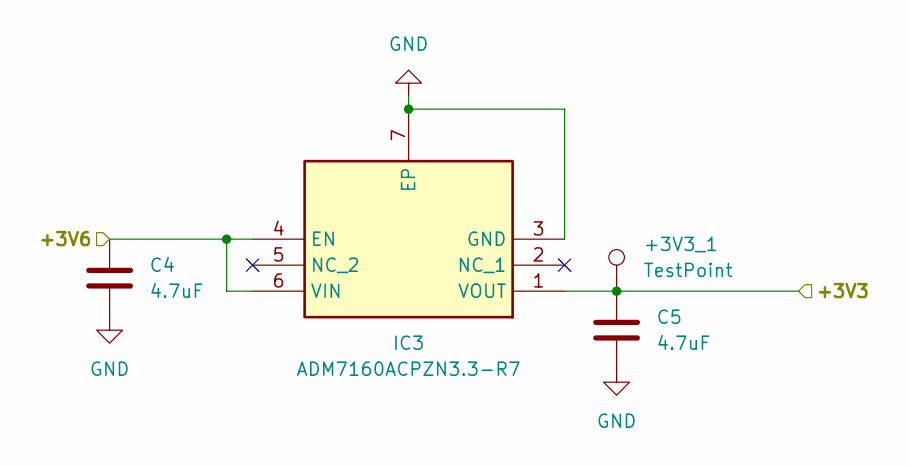
[picture p11: schematic ADM7160ACPZN3.3.kicad_sch]

Parts:
+3V3_1: TestPoint; TestPoint_Loop_D3.80mm_Drill2.5mm
C4, C5: 4.7uF; C_0603_1608Metric
IC3: ADM7160ACPZN3.3-R7; SON65P200X200X65-7N-D; Mouser Part Number 584-DM7160ACPZN3.3R7

Connections:
/Power/ADM7160ACPZN3.3_1/+3V3: +3V3_1.1, C5.1, IC3.1 (VOUT); also elsewhere on the board
/Power/ADM7160ACPZN3.3_1/+3V6: C4.1, IC3.4 (EN), IC3.6 (VIN); also elsewhere on the board
GND: C4.2, C5.2, IC3.3 (GND), IC3.7 (EP); also elsewhere on the board

Parts of its further copies:
+3V3_3, +3V3_4, +3V3_5: TestPoint; TestPoint_Loop_D3.80mm_Drill2.5mm
C33, C34, C35, C36, C67, C68: 4.7uF; C_0603_1608Metric
IC6, IC7, IC8: ADM7160ACPZN3.3-R7; SON65P200X200X65-7N-D; Mouser Part Number 584-DM7160ACPZN3.3R7

Connections of its further copies:
/Function Generator/AVDD: +3V3_3.1, C34.1, IC6.1 (VOUT); also elsewhere on the board
/Function Generator/CVDDX: +3V3_4.1, C36.1, IC7.1 (VOUT); also elsewhere on the board
/Power/ADM7160ACPZN3.3_1/+3V6: C33.1, C35.1, C67.1, IC6.4 (EN), IC6.6 (VIN), IC7.4 (EN), IC7.6 (VIN), IC8.4 (EN), IC8.6 (VIN); also elsewhere on the board
/Power/VDD_STM32: +3V3_5.1, C68.1, IC8.1 (VOUT); also elsewhere on the board
GND: C33.2, C34.2, C35.2, C36.2, C67.2, C68.2, IC6.3 (GND), IC6.7 (EP), IC7.3 (GND), IC7.7 (EP), IC8.3 (GND), IC8.7 (EP); also elsewhere on the board

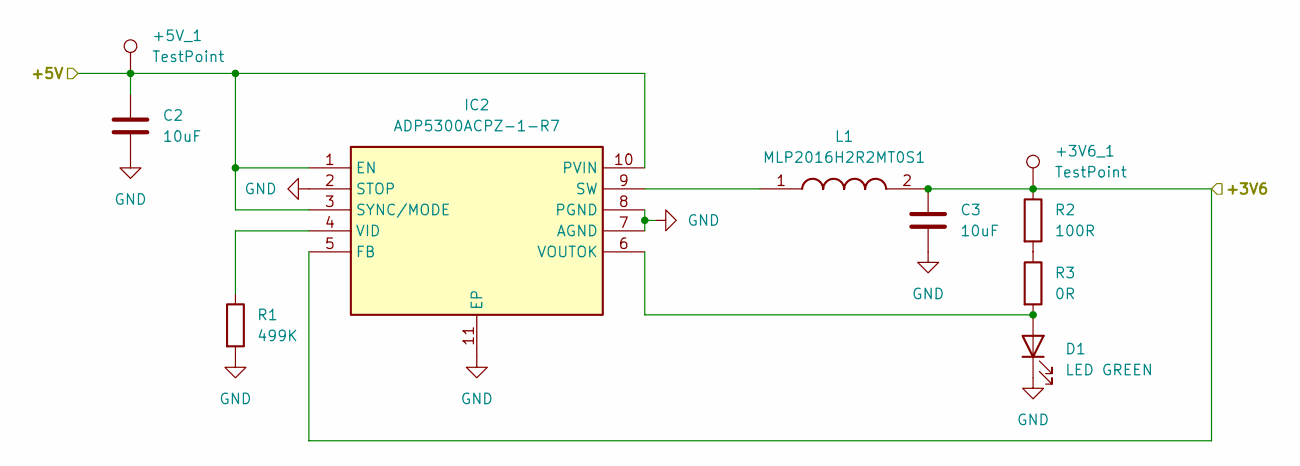
[picture p12: schematic ADP5300ACPZ-1.kicad_sch]

Parts:
+3V6_1, +5V_1: TestPoint; TestPoint_Loop_D3.80mm_Drill2.5mm
C2, C3: 10uF; C_0603_1608Metric
D1: LED GREEN; LED_0603_1608Metric
IC2: ADP5300ACPZ-1-R7; SON50P300X300X85-11N-D; Mouser Part Number 584-ADP5300ACPZ-1-R7
L1: MLP2016H2R2MT0S1; INDC2016X100N; Mouser Part Number 810-MLP2016H2R2MT0S1
R1: 499K; R_0603_1608Metric
R2: 100R; R_0603_1608Metric
R3: 0R; R_0603_1608Metric

Connections:
/Power/5V: +5V_1.1, C2.1, IC2.1 (EN), IC2.3 (SYNC/MODE), IC2.10 (PVIN); also elsewhere on the board
/Power/ADM7160ACPZN3.3_1/+3V6: +3V6_1.1, C3.1, IC2.5 (FB), L1.2, R2.1; also elsewhere on the board
GND: C2.2, C3.2, D1.1 (K), IC2.2 (STOP), IC2.7 (AGND), IC2.8 (PGND), IC2.11 (EP), R1.2; also elsewhere on the board
unnamed: D1.2 (A), IC2.6 (VOUTOK), R3.2
unnamed: IC2.9 (SW), L1.1
unnamed: IC2.4 (VID), R1.1
unnamed: R2.2, R3.1

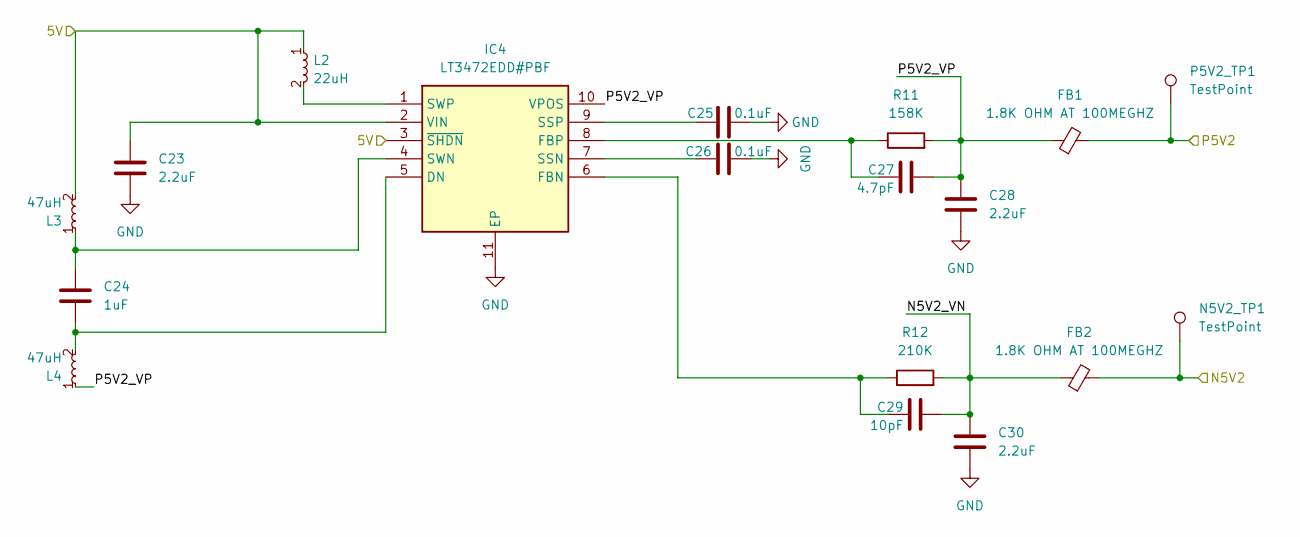
[picture p13: schematic LT3472EDD.kicad_sch]

Parts:
C23, C28, C30: 2.2uF; C_0603_1608Metric
C24: 1uF; C_0603_1608Metric
C25, C26: 0.1uF; C_0603_1608Metric
C27: 4.7pF; C_0603_1608Metric
C29: 10pF; C_0603_1608Metric
FB1, FB2: 1.8K OHM AT 100MEGHZ; L_0603_1608Metric
IC4: LT3472EDD#PBF; SON50P300X300X80-11N-D; Mouser Part Number 584-LT3472EDD#PBF
L2: 22uH; LQH32CH100K53L; Mouser Part Number 81-LQH32CN220K53L
L3, L4: 47uH; LQH32CH100K53L; Mouser Part Number 81-LQH32CN470K53L
N5V2_TP1: TestPoint; TestPoint_Loop_D3.80mm_Drill2.5mm
P5V2_TP1: TestPoint; TestPoint_Loop_D3.80mm_Drill2.5mm
R11: 158K; R_0603_1608Metric
R12: 210K; R_0603_1608Metric

Connections:
/Output_Stage/N5V2: FB2.2, N5V2_TP1.1; also elsewhere on the board
/Output_Stage/P5V2: FB1.2, P5V2_TP1.1; also elsewhere on the board
/Power/5V: C23.1, IC4.2 (VIN), IC4.3 (~SHDN), L2.1, L2.3, L3.2, L3.4; also elsewhere on the board
/Power/LT3472EDD/N5V2_VN: C29.2, C30.1, FB2.1, R12.2
/Power/LT3472EDD/P5V2_VP: C27.2, C28.1, FB1.1, IC4.10 (VPOS), L4.1, L4.3, R11.2
GND: C23.2, C25.2, C26.2, C28.2, C30.2, IC4.11 (EP); also elsewhere on the board
unnamed: C24.2, IC4.5 (DN), L4.2, L4.4
unnamed: C29.1, IC4.6 (FBN), R12.1
unnamed: C27.1, IC4.8 (FBP), R11.1
unnamed: C26.1, IC4.7 (SSN)
unnamed: C25.1, IC4.9 (SSP)
unnamed: C24.1, IC4.4 (SWN), L3.1, L3.3
unnamed: IC4.1 (SWP), L2.2, L2.4

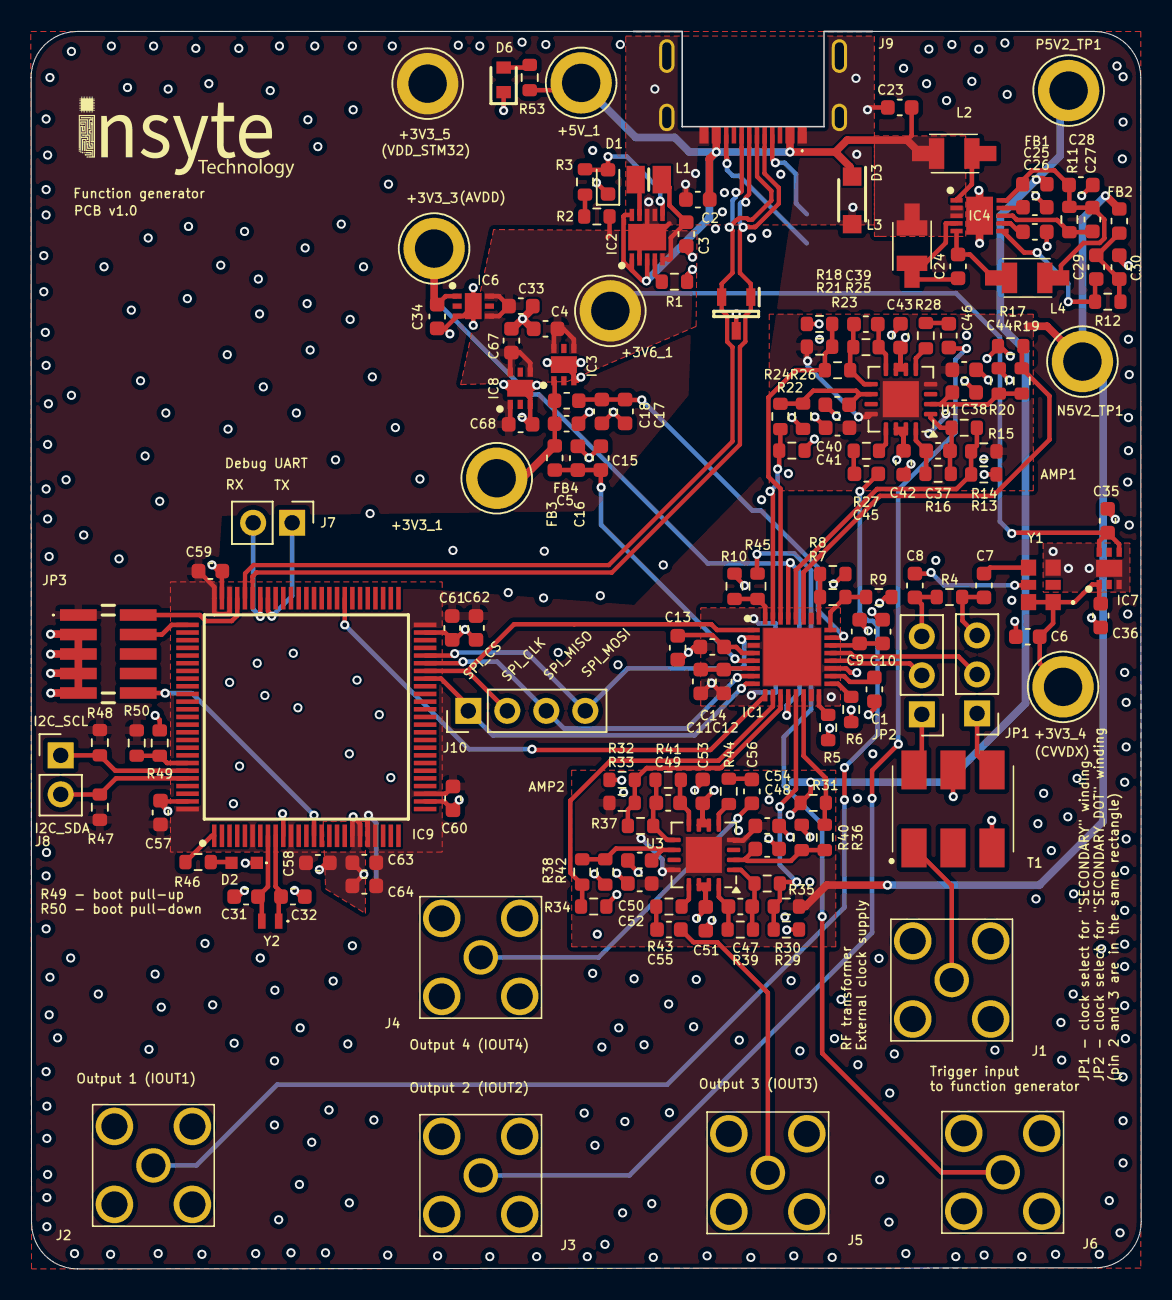
[picture p14: board Minimal_Prototype_Function_Generator_V0.1.kicad_pcb from above]

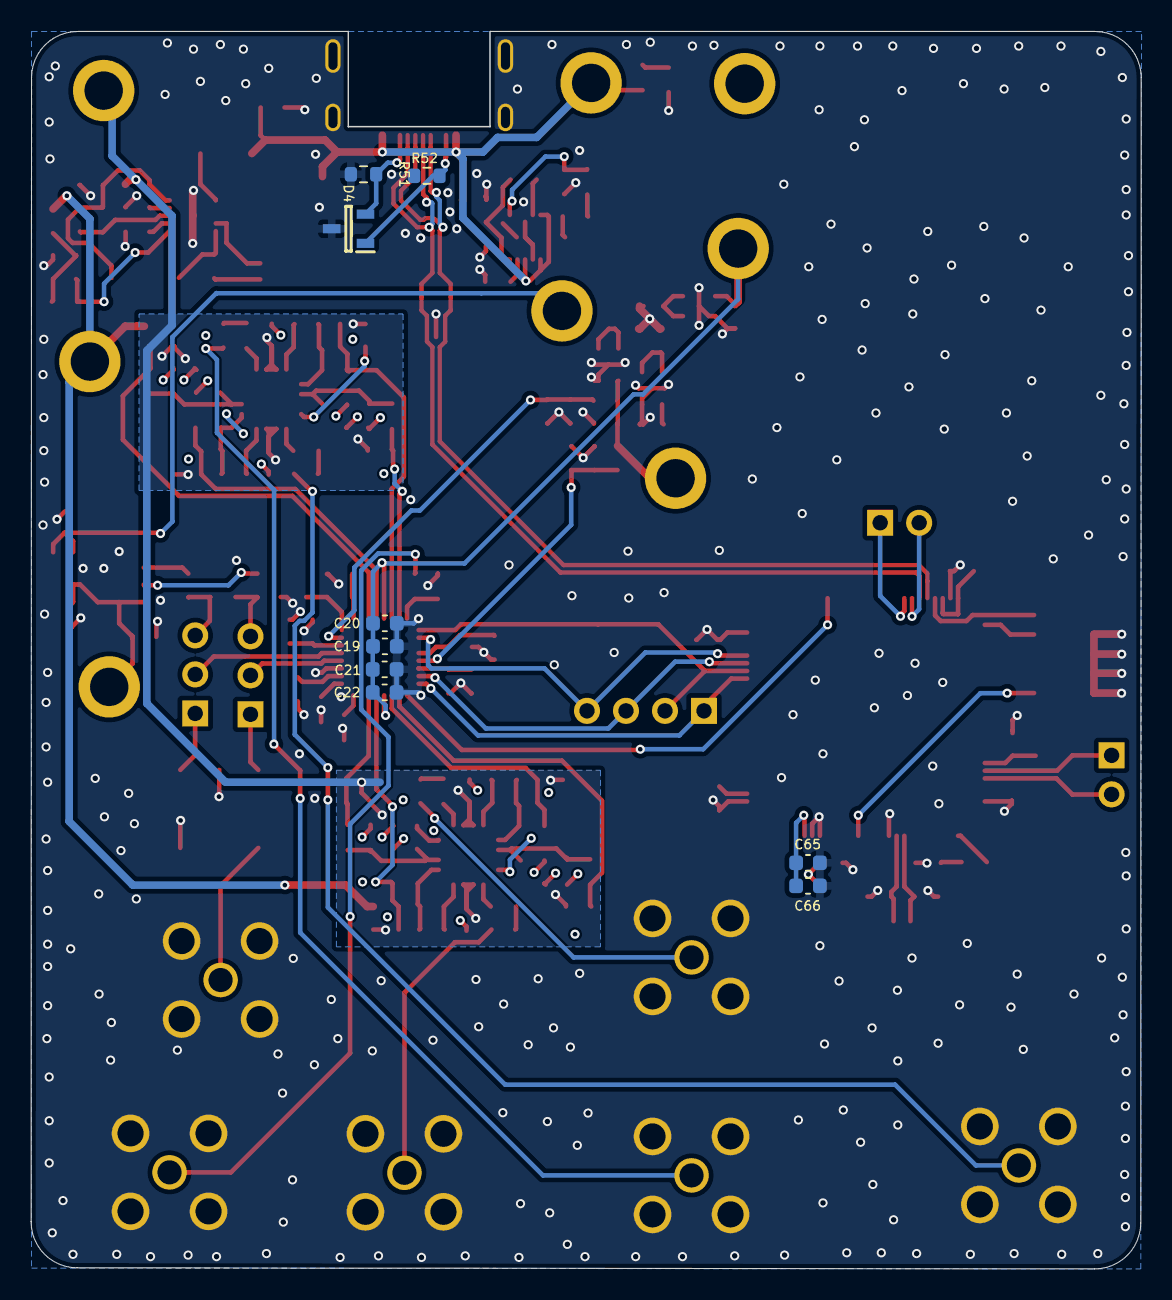
[picture p15: board Minimal_Prototype_Function_Generator_V0.1.kicad_pcb from below]

Board: 4 copper layers, 72.3 x 80.6 mm, 170 parts (9 on the bottom side), 97 nets.
