JopKoning-InsyteTechnology/EFRO_Breast_Cancer_Detection/(commit log)

2025-09-08 First schematic
    [AD9106.kicad_sch, ADM7160ACPZN3.3.kicad_sch, ADP5300ACPZ-1.kicad_sch, BOM.csv, LT3472EDD.kicad_sch, Minimal_Prototype_Function_Generator_V0.1.csv, Minimal_Prototype_Function_Generator_V0.1.kicad_pcb, Minimal_Prototype_Function_Generator_V0.1.kicad_sch]
2025-09-09 Routing PCB, not yet finished
    [AD9106.kicad_sch, LT3472EDD.kicad_sch, Minimal_Prototype_Function_Generator_V0.1.kicad_pcb, USB_C.kicad_sch]
2025-09-10 Preliminary delivery of PCB, v0.1
    [Minimal_Prototype_Function_Generator_V0.1.kicad_pcb, USB_C.kicad_sch]
2025-09-11 PCB delivery, v1.0
    [Minimal_Prototype_Function_Generator_V0.1.kicad_pcb, STM32.kicad_sch]
2025-09-12 Added schematic documentation
2025-09-15 Implemented almost all feedback
    [AD9106.kicad_sch, Minimal_Prototype_Function_Generator_V0.1.kicad_pcb, USB_C.kicad_sch]
2025-09-15 Updated schemattic documentation
    [Minimal_Prototype_Function_Generator_V0.1.kicad_sch]
2025-09-15 Updated PCB and schematic, according to feedback
    [Minimal_Prototype_Function_Generator_V0.1.kicad_pcb, Minimal_Prototype_Function_Generator_V0.1.kicad_sch]
2025-09-23 Ready for order
    [Minimal_Prototype_Function_Generator_V0.1.kicad_pcb, bom.csv, designators.csv, positions.csv]
2025-09-29 Added info on impedance matching
    [Minimal_Prototype_Function_Generator_V0.1.kicad_sch]
